vmarzlin/ValTronix-MP0003-Clock/MP0003_Schema.pdf

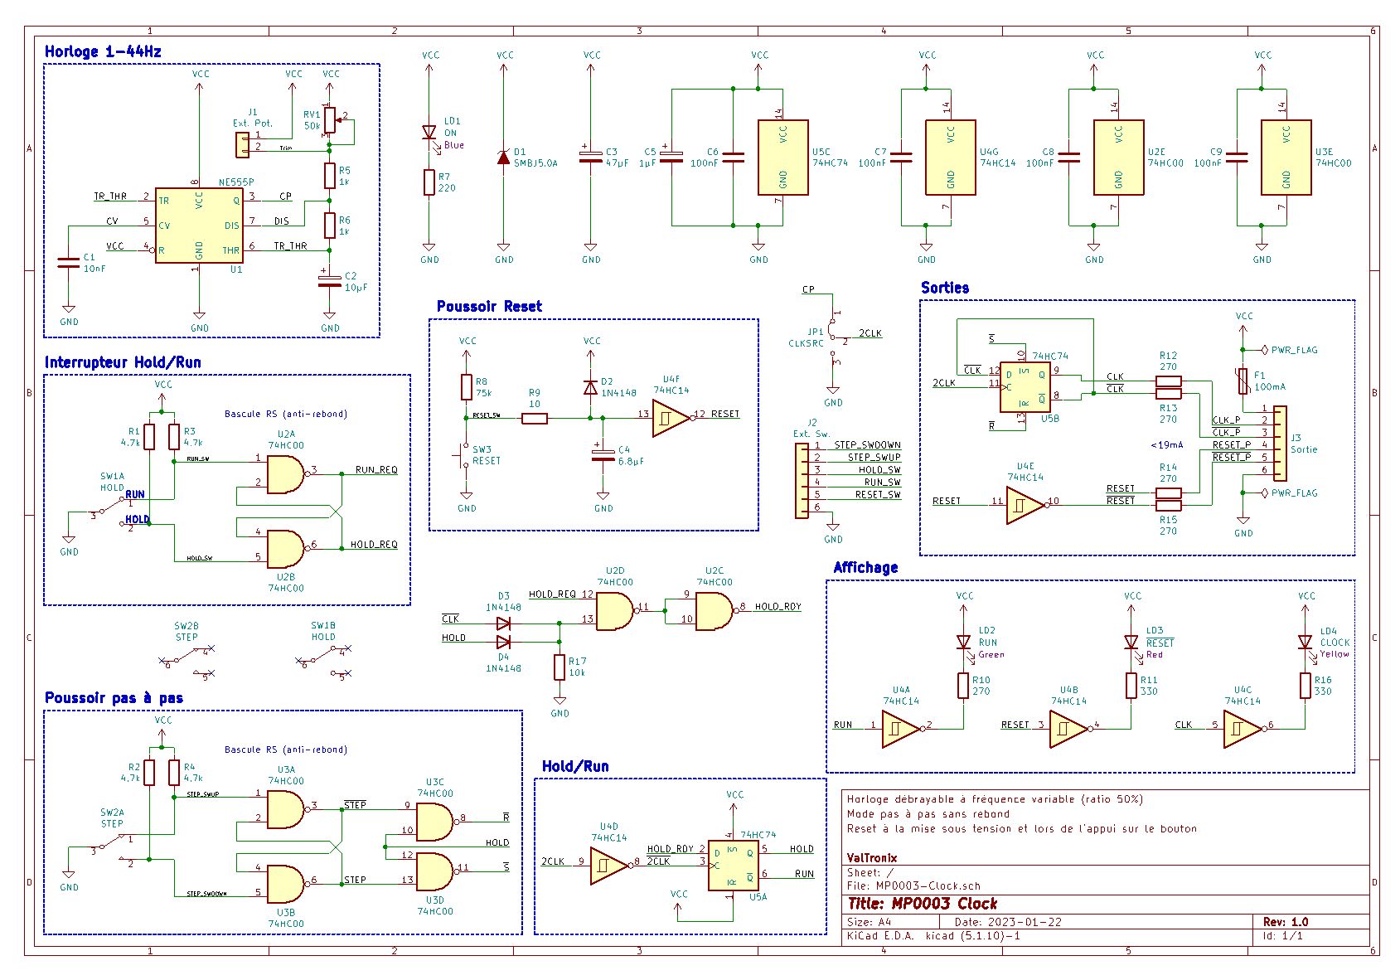
[picture p3: page 1]
