vmarzlin/ValTronix-MP0003-Clock/Clock_detail.png

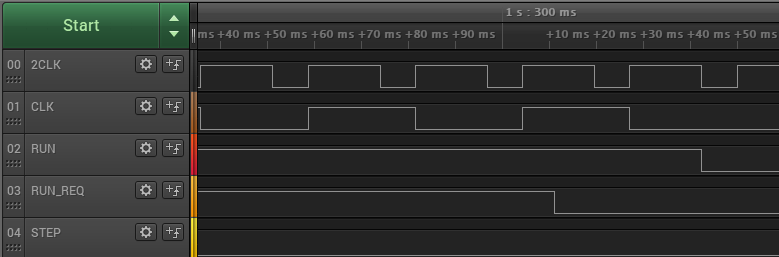
Clock_detail.png
