vmarzlin/ValTronix-MP0003-Clock/Clock_high.png

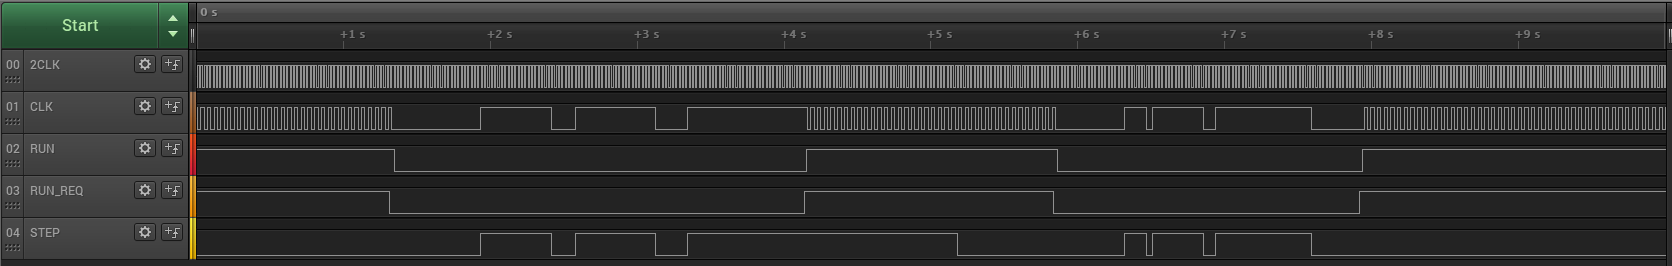
Clock_high.png
