vmarzlin/ValTronix-MP0003-Clock/MP0003_illustration.jpg

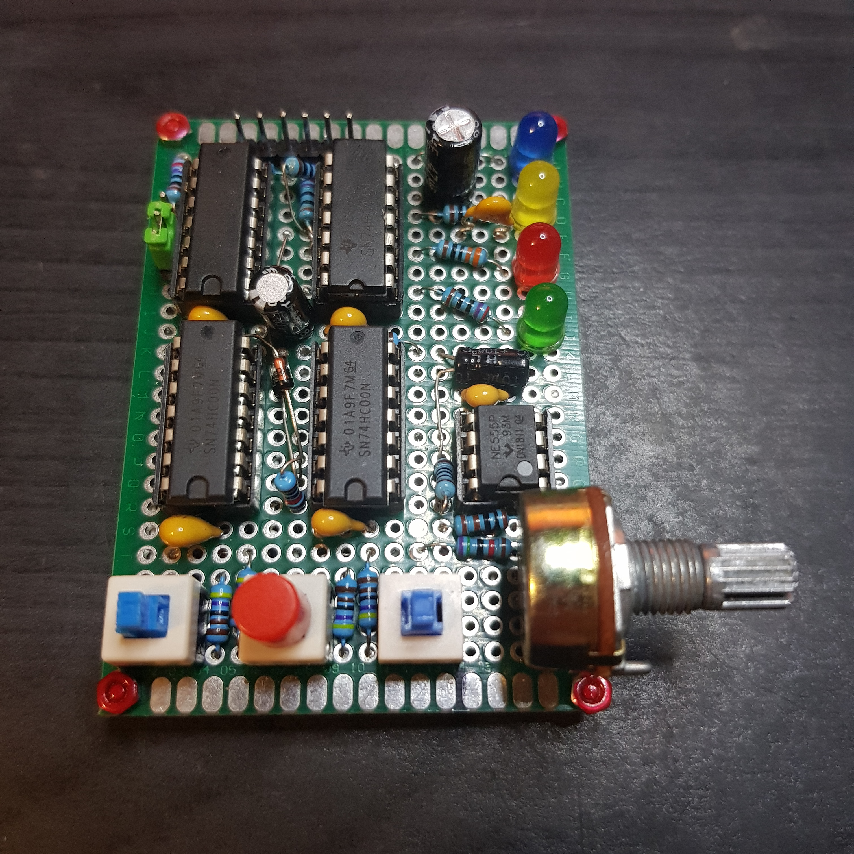
MP0003_illustration.jpg
