vmarzlin/ValTronix-MP0003-Clock/Preview.png

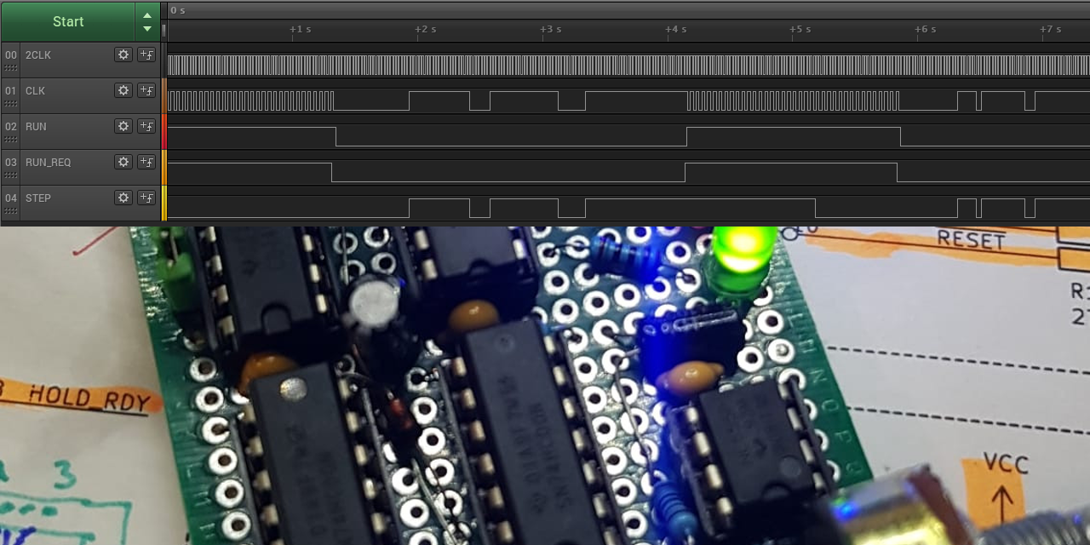
Preview.png
