vmarzlin/ValTronix-MP0003-Clock/MP0003-Clock.sch

## KiCad design MP0003-Clock.sch (2023-03-20, an earlier design)

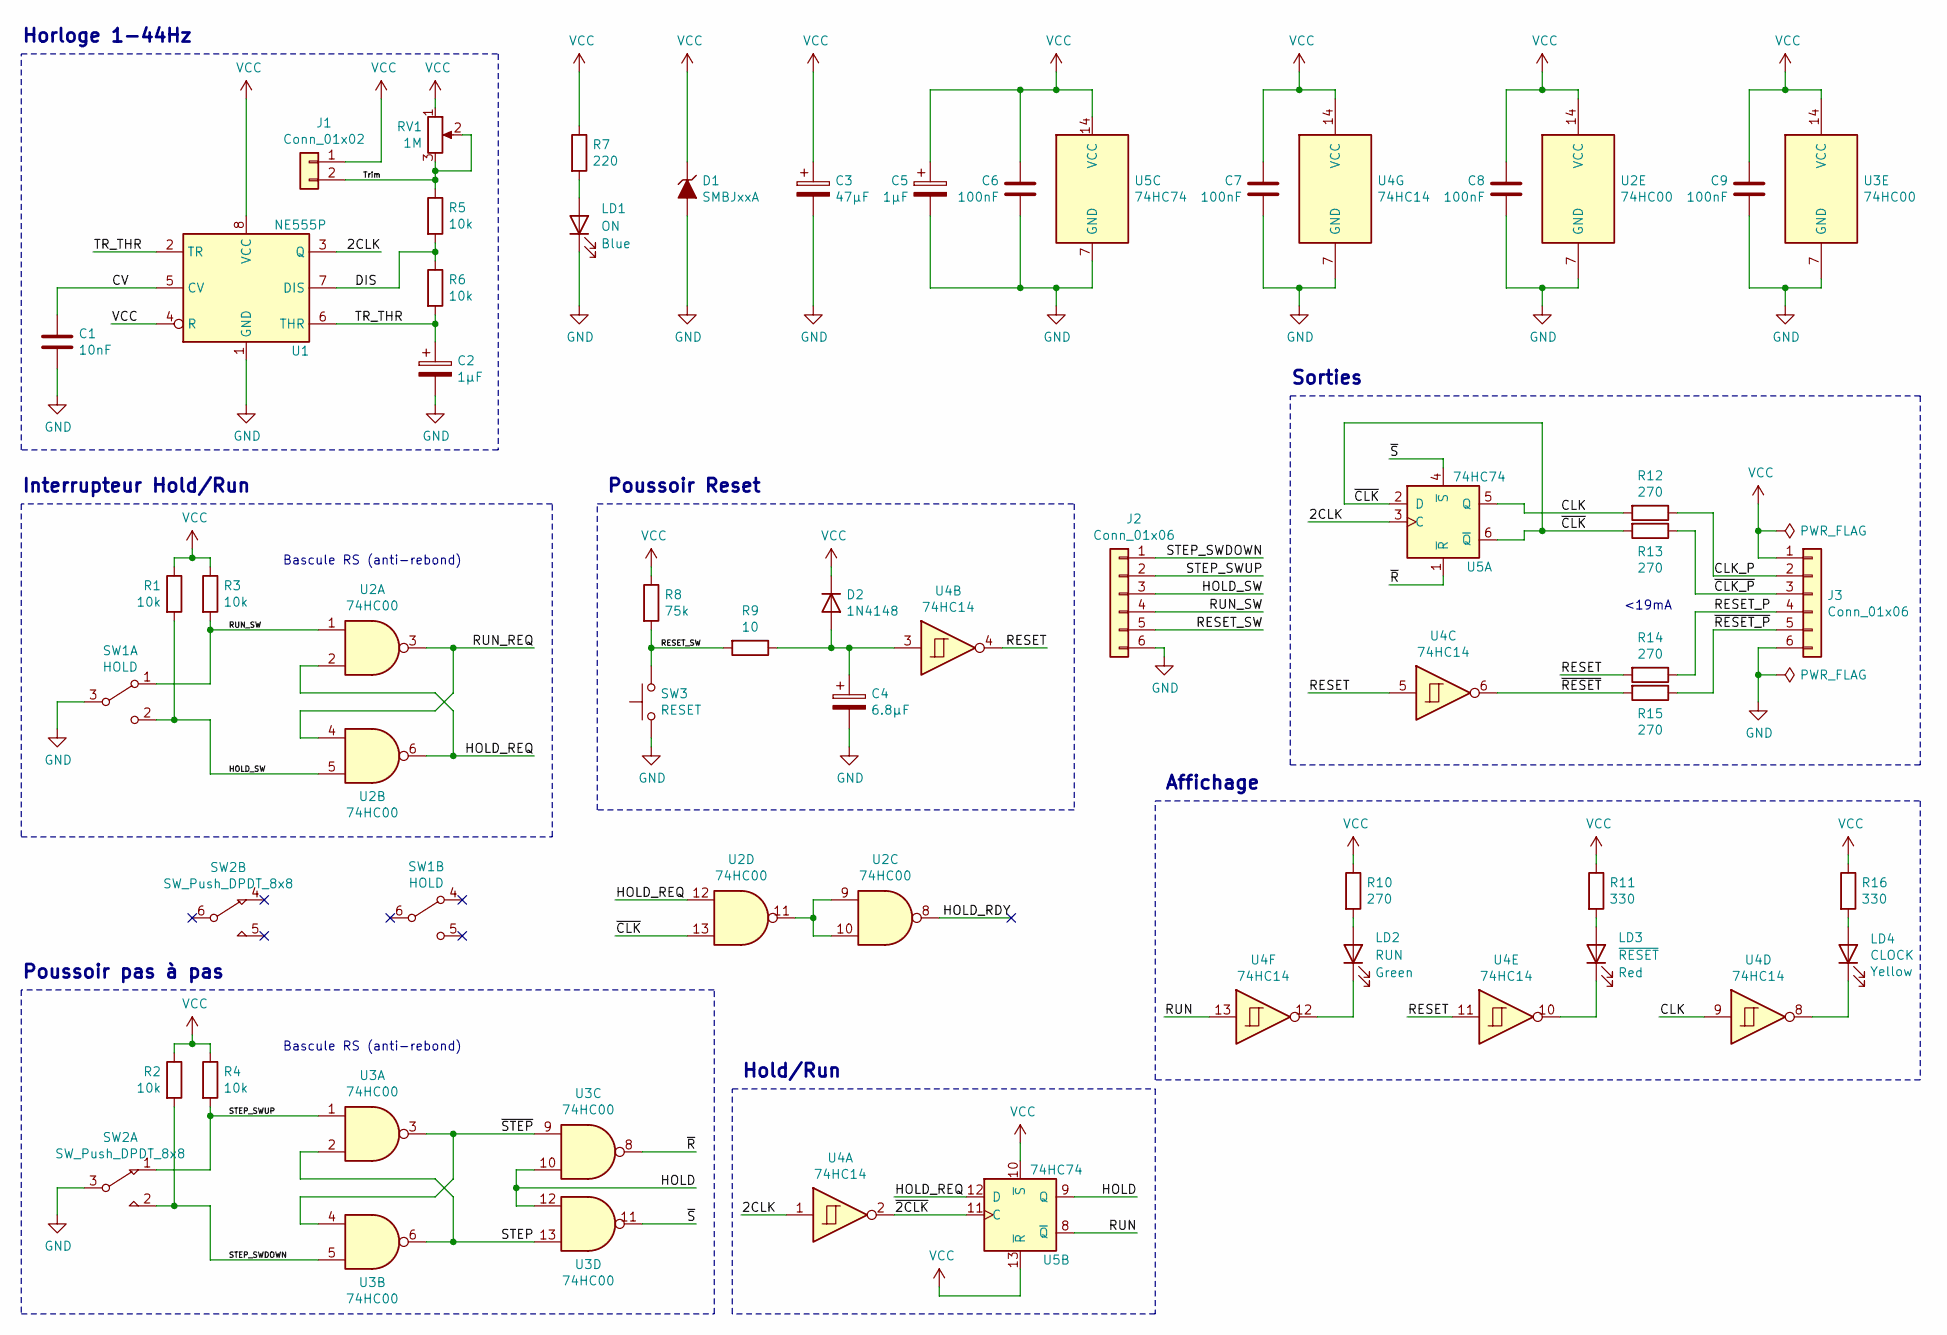
[picture p8: schematic MP0003-Clock.sch]

Parts:
C1: 10nF
C2, C5: 1µF
C3: 47µF
C4: 6.8µF
C6, C7, C8, C9: 100nF
D1: SMBJxxA; D_SMB
D2: 1N4148; D_DO-35_SOD27_P7.62mm_Horizontal
J1: Conn_01x02
J2, J3: Conn_01x06
LD1: ON; LED_D5.0mm
LD2: RUN; LED_D5.0mm
LD3: ~RESET; LED_D5.0mm
LD4: CLOCK; LED_D5.0mm
R1, R2, R3, R4, R5, R6: 10k
R7: 220
R8: 75k
R9: 10
R10, R12, R13, R14, R15: 270
R11, R16: 330
RV1: 1M
SW1: HOLD; SW_Push_DPDT_8x8mm
SW2: SW_Push_DPDT_8x8; SW_Push_DPDT_8x8mm
SW3: RESET
U1: NE555P; DIP-8_W7.62mm
U2, U3: 74HC00; DIP-14_W7.62mm
U4: 74HC14; DIP-14_W7.62mm
U5: 74HC74; DIP-14_W7.62mm

Connections:
2CLK: U1.3 (Q), U4.1, U5.3 (C)
CLK: R12.2, U4.9, U5.5 (Q)
CLK_P: J3.2, R12.1
CV: C1.1, U1.5 (CV)
DIS: R5.2, R6.1, U1.7 (DIS)
GND: C1.2, C2.2, C3.2, C4.2, C5.2, C6.2, C7.2, C8.2, C9.2, D1.2 (A2), J2.6, J3.6, LD1.1 (K), SW1.3 (B), SW2.3 (B), SW3.1, U1.1 (GND), U2.7 (GND), U3.7 (GND), U4.7 (GND), U5.7 (GND)
HOLD: U3.10, U3.12, U5.9 (Q)
HOLD_RDY: U2.8
HOLD_REQ: U2.2, U2.6, U2.12, U5.12 (D)
HOLD_SW: J2.3, R1.2, SW1.2 (C), U2.5
unnamed: C4.1, D2.2 (A), R9.1, U4.3
unnamed: LD1.2 (A), R7.2
unnamed: LD2.1 (K), U4.12
unnamed: LD2.2 (A), R10.2
unnamed: LD3.1 (K), U4.10
unnamed: LD3.2 (A), R11.2
unnamed: LD4.1 (K), U4.8
unnamed: LD4.2 (A), R16.2
unnamed: U2.9, U2.10, U2.11
RESET: R14.2, U4.4, U4.5, U4.11
RESET_P: J3.4, R14.1
RESET_SW: J2.5, R8.2, R9.2, SW3.2
RUN: U4.13, U5.8 (~Q)
RUN_REQ: U2.3, U2.4
RUN_SW: J2.4, R3.2, SW1.1 (A), U2.1
STEP: U3.2, U3.6, U3.13
STEP_SWDOWN: J2.1, R2.2, SW2.2 (C), U3.5
STEP_SWUP: J2.2, R4.2, SW2.1 (A), U3.1
TR_THR: C2.1, R6.2, U1.2 (TR), U1.6 (THR)
Trim: J1.2, R5.1, RV1.2, RV1.3
VCC: C3.1, C5.1, C6.1, C7.1, C8.1, C9.1, D1.1 (A1), D2.1 (K), J1.1, J3.1, R1.1, R2.1, R3.1, R4.1, R7.1, R8.1, R10.1, R11.1, R16.1, RV1.1, U1.4 (R), U1.8 (VCC), U2.14 (VCC), U3.14 (VCC), U4.14 (VCC), U5.10 (~S), U5.13 (~R), U5.14 (VCC)
~2CLK: U4.2, U5.11 (C)
~CLK: R13.2, U2.13, U5.2 (D), U5.6 (~Q)
~CLK_P: J3.3, R13.1
~R: U3.8, U5.1 (~R)
~RESET: R15.2, U4.6
~RESET_P: J3.5, R15.1
~S: U3.11, U5.4 (~S)
~STEP: U3.3, U3.4, U3.9

Notes on the sheet:
Horloge 1-44Hz
<19mA
Sorties
Affichage
Interrupteur Hold/Run
Poussoir pas à pas
Hold/Run
Poussoir Reset
Bascule RS (anti-rebond)
