vmarzlin/ValTronix-MP0003-Clock/(commit log)

2023-01-11 Première version du projet. Testé OK sur breadboard. Voir pour simplifier et remplacer par bascules JK?
    [MP0000-Template.sch, MP0003-Clock.kicad_pcb, MP0003-Clock.sch]
2023-01-16 Ajout dun fusible réarmable, correction bug basculement mode RUM/HOLD Montage testé et validé sur breadboard. Mesures validées à l'analyseur logique
    [MP0003-Clock.sch]
2023-01-22 Passage à la version 1.0 du plan. Ajout d'un jumper pour utiliser une source externe d'horloge et ajout d'un polyswitch en sécurité. Testé et validé sur breadbord et proto. Note: pas de PCB.
    [MP0003-Clock.sch]
2023-03-20 Version 1, totalement fonctionnelle avec photos réalisation et documentation
    [MP0003-Clock.sch, NE555 fréquence variable.ods, NE555 fréquence variable.xlsx]
